ramonavila04/ME102B/cad/onshape/Pill_Dispenser_Clip_On_Canister_67p5mm.step.step

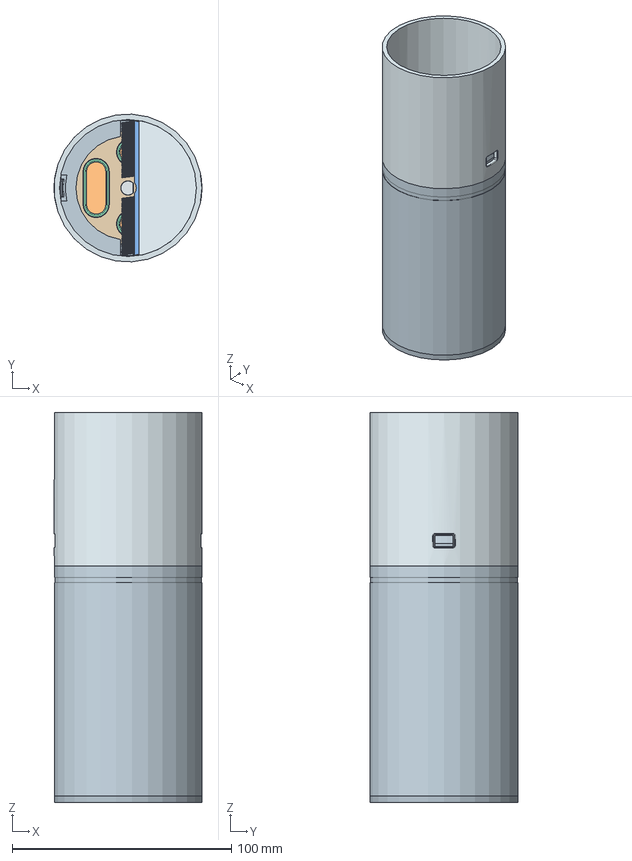
[picture p1: CAD file, 2026-11-14]
cad/onshape/Pill_Dispenser_Clip_On_Canister_67p5mm.step.step
67.5 x 67.4 x 178.0 mm
Lower_enclosure_with_integrated_snap_clips
Unchanged_pill_opening_3
Stationary_floor
Center_motor_shaft_coupler
Center_shaft_bushing_2
Internal_motor_and_shaft_mount
Separate_vertical_pill_chute
Removable_flush_bottom_service_cap
Unchanged_pill_opening_2
Center_D_drive_shaft
Unchanged_pill_opening_1
Centered_original_size_motor
Three_tangential_pocket_rotor
Canister_OD67p5_H70
Floor_liner_unchanged_depth
Full_width_brush_holder
REFERENCE_ONLY_Flexible_Bristles x 69
Center_shaft_bushing_1
