ramonavila04/ME102B/(commit log)

2026-11-08 Add Onshape-to-GitHub CAD sync and import TFT test sketch
    Nightly/manual GitHub Action exports listed Onshape Part Studios and
    Assemblies to STEP/STL in cad/onshape/ using Onshape API keys stored as
    repository secrets. Not yet run against a real document.
    Claude-Session: https://claude.ai/code/session_01SjSWa2f3QdP7LKqrEfo4Bm
2026-11-09 Added current cad file
2026-11-09 Sync CAD exports from Onshape
    [Pill_Dispenser_Clip_On_Canister_67p5mm.step.step]
